win7-rar/Sub-100-Wh-portable-power-station/20261030_233057.jpg

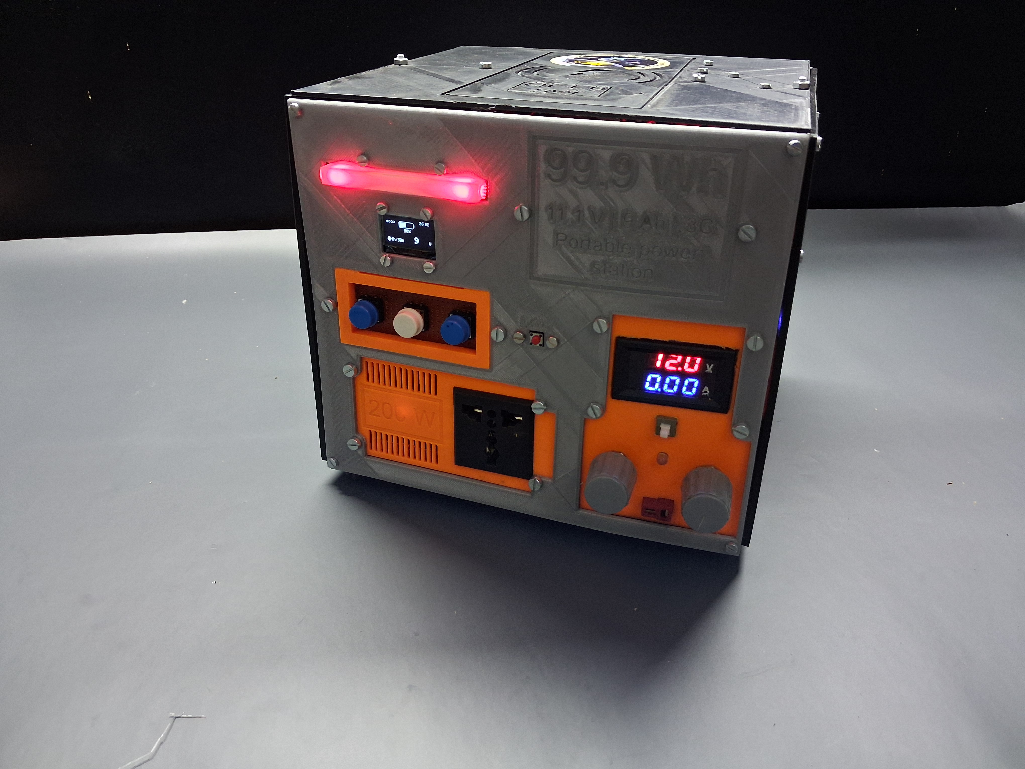
20261030_233057.jpg
