win7-rar/Sub-100-Wh-portable-power-station/20261030_232830.jpg

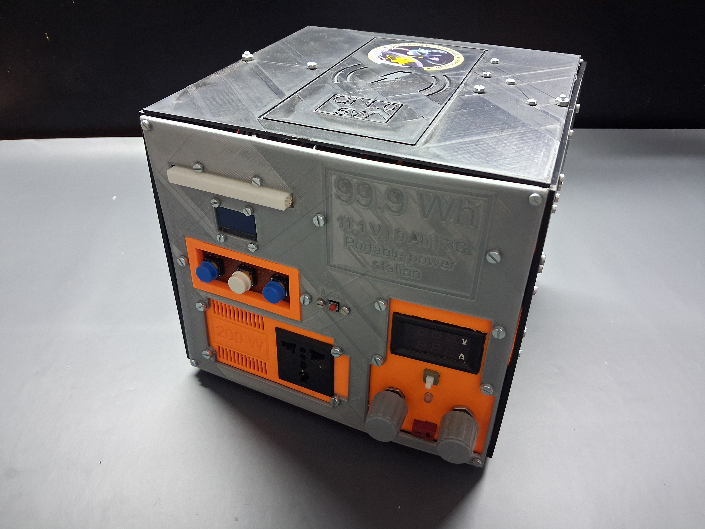
20261030_232830.jpg
