win7-rar/Sub-100-Wh-portable-power-station/PCB/readme.txt

Hi, the circuit I made was one with perf board with random/unplanned placements and connections. This folder
contains circuit diagrams, circuit ideas and solutions to problems. It also contains other miscellaneous information
such as voltage and other characteristics overtime.
