win7-rar/Sub-100-Wh-portable-power-station/20261030_232907.jpg

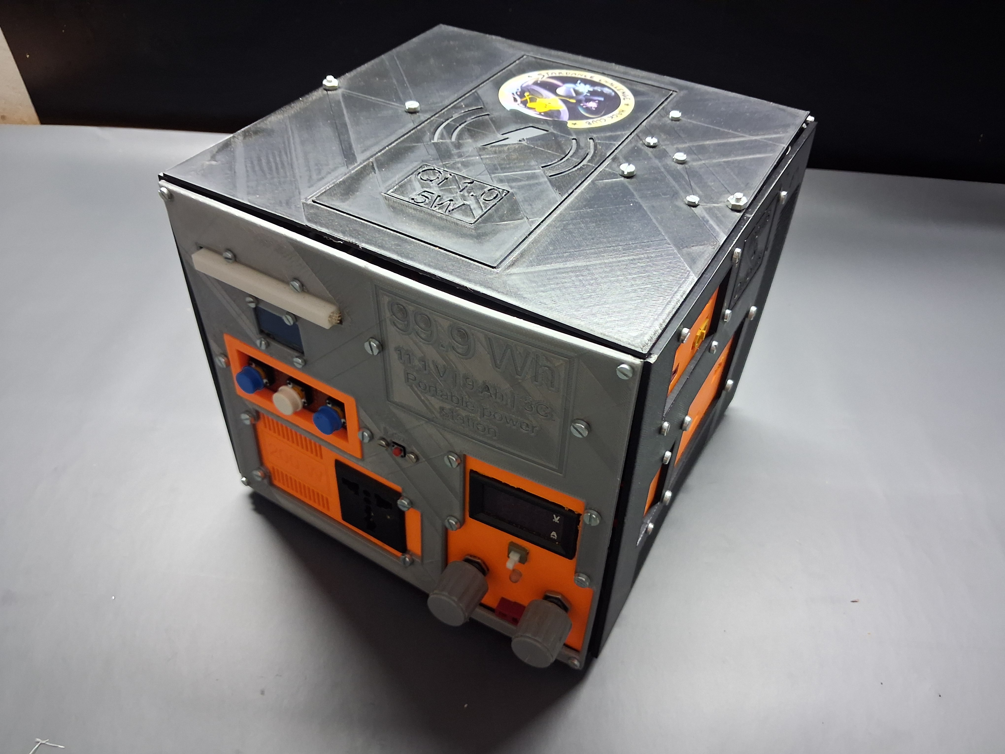
20261030_232907.jpg
