win7-rar/Sub-100-Wh-portable-power-station/PCB/20261030_222210.jpg

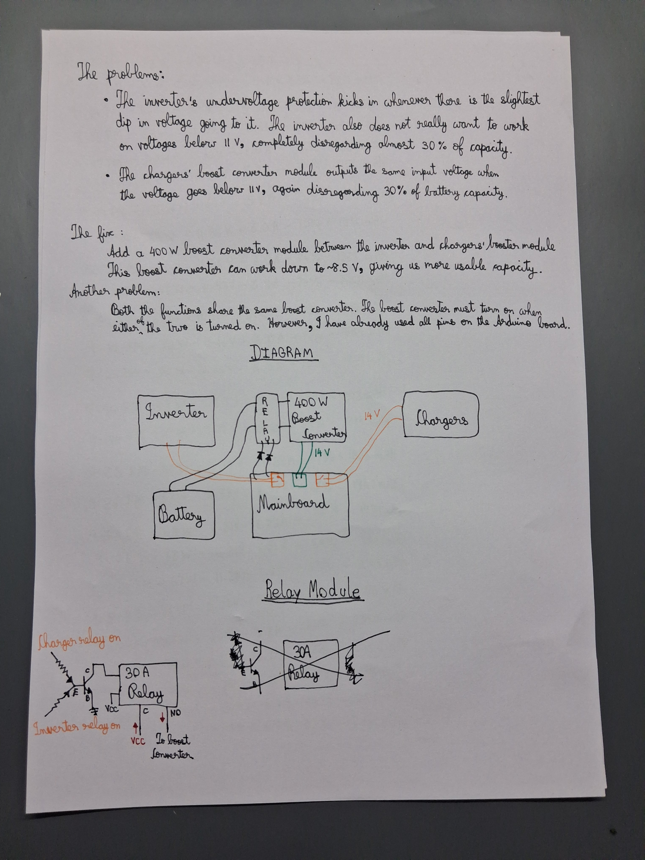
PCB/20261030_222210.jpg
