win7-rar/Sub-100-Wh-portable-power-station/STEP/Mainboard frame bracket.step

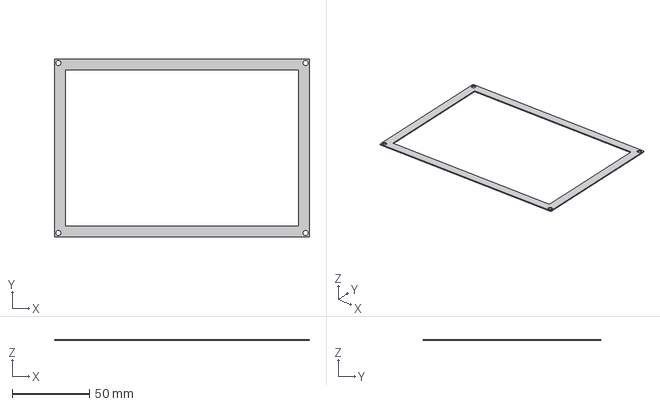
[picture p12: CAD file, 2026-10-30]
STEP/Mainboard frame bracket.step
165.0 x 115.0 x 0.8 mm
