win7-rar/Sub-100-Wh-portable-power-station/STEP/Mainboard mount - right.step

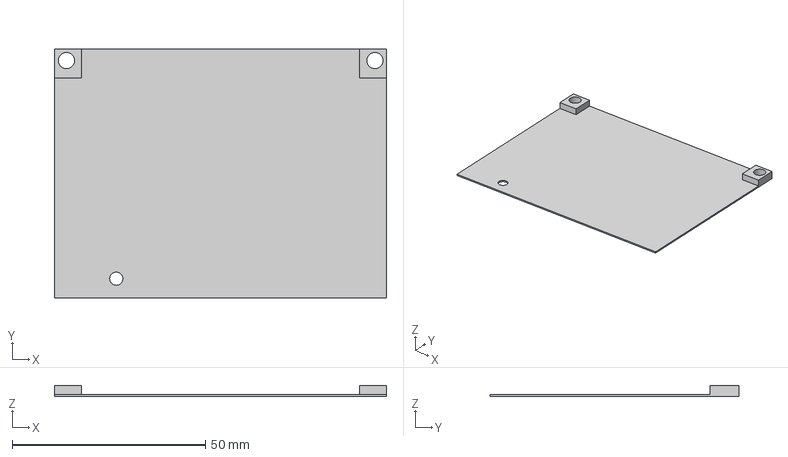
[picture p13: CAD file, 2026-10-30]
STEP/Mainboard mount - right.step
86.0 x 64.5 x 2.80 mm
