win7-rar/Sub-100-Wh-portable-power-station/STEP/Main board mount - left.step

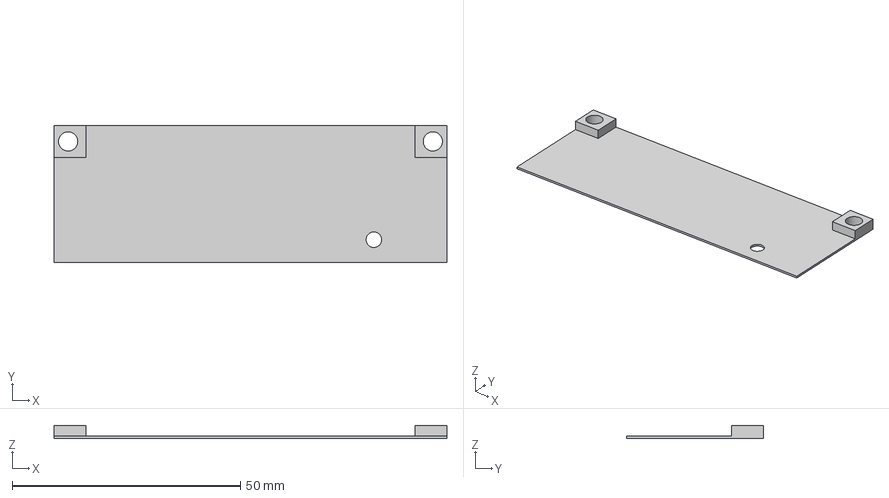
[picture p14: CAD file, 2026-10-30]
STEP/Main board mount - left.step
86.0 x 30.0 x 2.80 mm
