win7-rar/Sub-100-Wh-portable-power-station/STEP/Mainboard frame.step

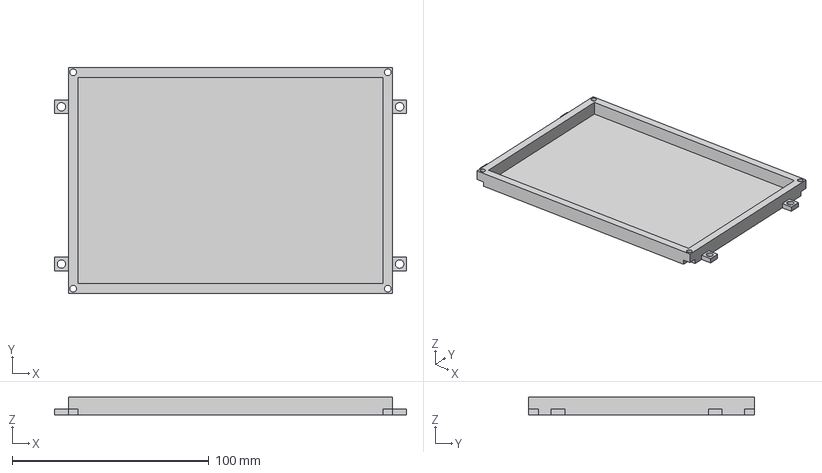
[picture p15: CAD file, 2026-10-30]
STEP/Mainboard frame.step
179.0 x 115.0 x 9.00 mm
