win7-rar/Sub-100-Wh-portable-power-station/STEP/Back panel.step

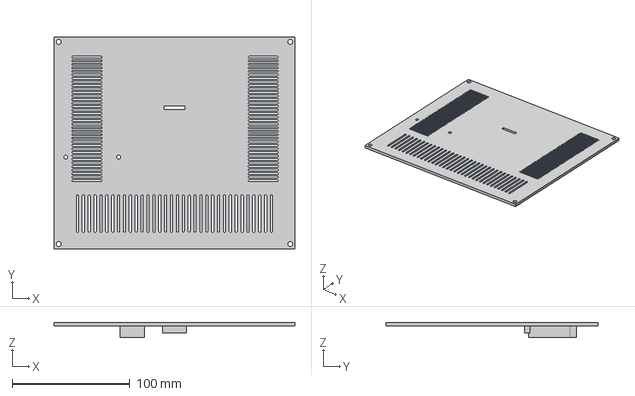
[picture p16: CAD file, 2026-10-30]
STEP/Back panel.step
205.0 x 180.0 x 13.0 mm
