win7-rar/Sub-100-Wh-portable-power-station/STEP/Buttons mount cover.step

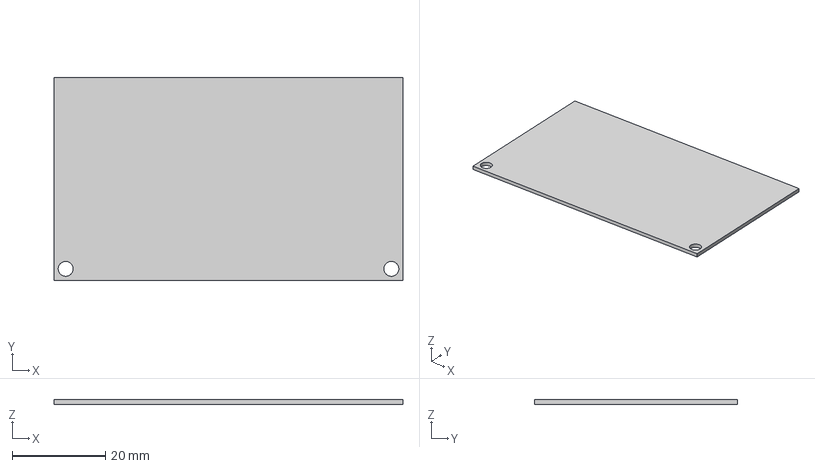
[picture p17: CAD file, 2026-10-30]
STEP/Buttons mount cover.step
75.0 x 43.6 x 1.00 mm
