win7-rar/Sub-100-Wh-portable-power-station/STEP/Bench power supply mount.step

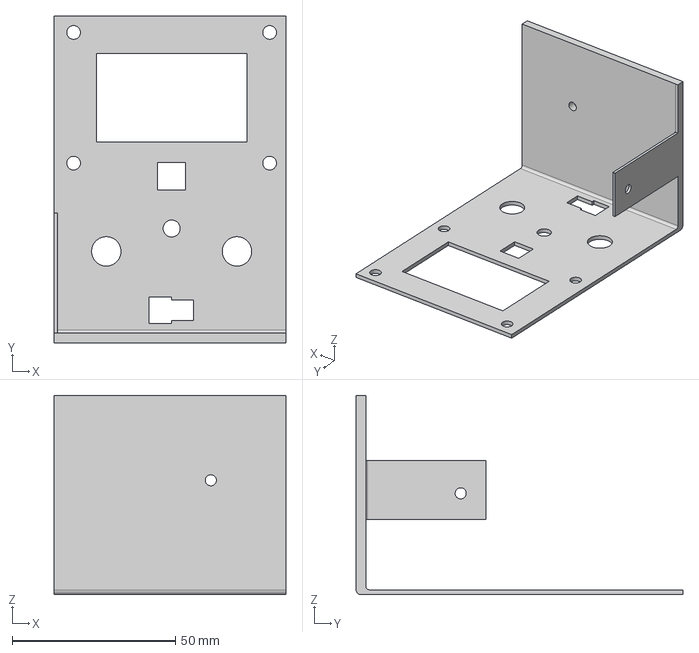
[picture p18: CAD file, 2026-10-30]
STEP/Bench power supply mount.step
71.0 x 100.0 x 61.0 mm
