win7-rar/Sub-100-Wh-portable-power-station/STEP/Inverter case top.step

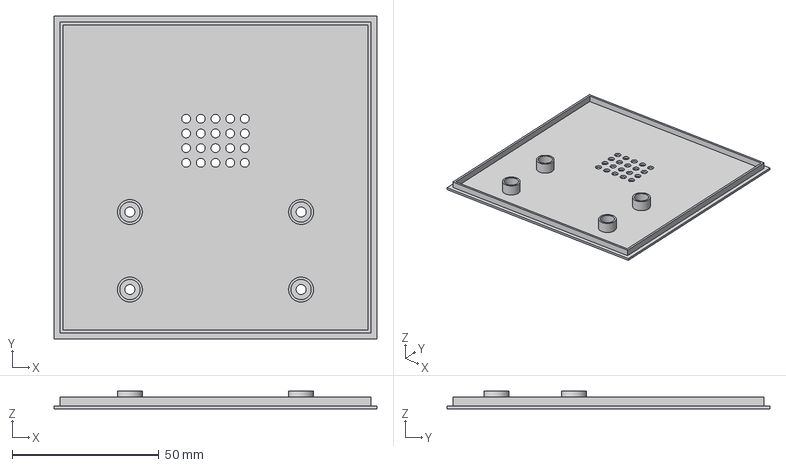
[picture p19: CAD file, 2026-10-30]
STEP/Inverter case top.step
110.0 x 110.0 x 6.00 mm
