win7-rar/Sub-100-Wh-portable-power-station/STEP/Power button mount.step

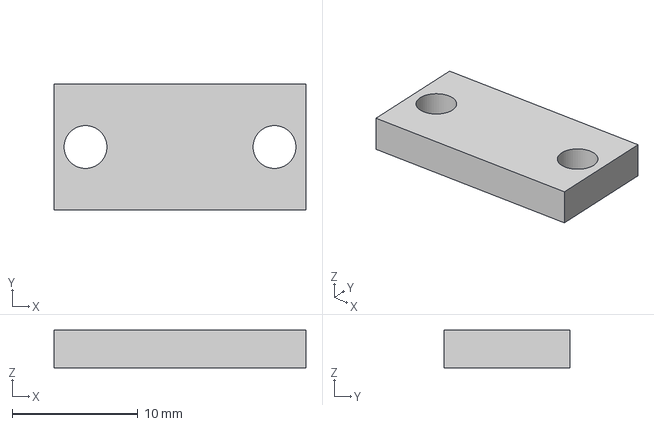
[picture p20: CAD file, 2026-10-30]
STEP/Power button mount.step
20.0 x 10.0 x 3.00 mm
