win7-rar/Sub-100-Wh-portable-power-station/STEP/Battery holder cover.step

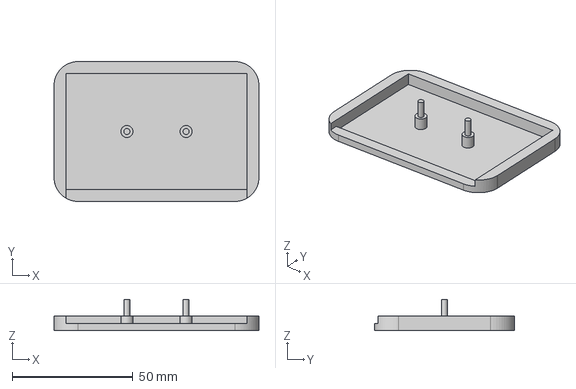
[picture p21: CAD file, 2026-10-30]
STEP/Battery holder cover.step
85.0 x 58.0 x 13.0 mm
