win7-rar/Sub-100-Wh-portable-power-station/STEP/Lamp bracket.step

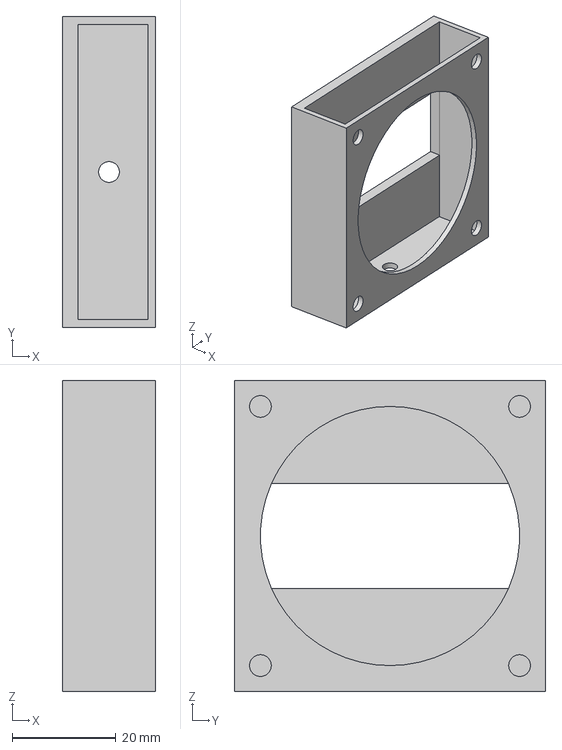
[picture p22: CAD file, 2026-10-30]
STEP/Lamp bracket.step
18.0 x 60.0 x 60.0 mm
