win7-rar/Sub-100-Wh-portable-power-station/STEP/Lamp bracket cover.step

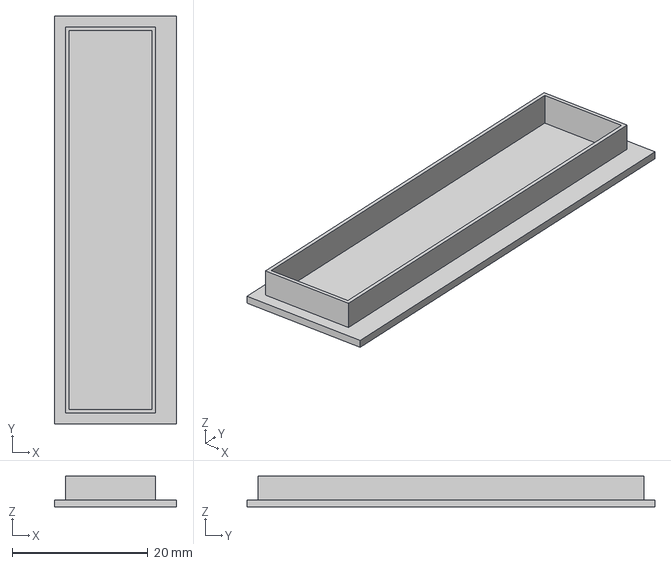
[picture p23: CAD file, 2026-10-30]
STEP/Lamp bracket cover.step
18.0 x 60.0 x 4.50 mm
