win7-rar/Sub-100-Wh-portable-power-station/STEP/Feet.step

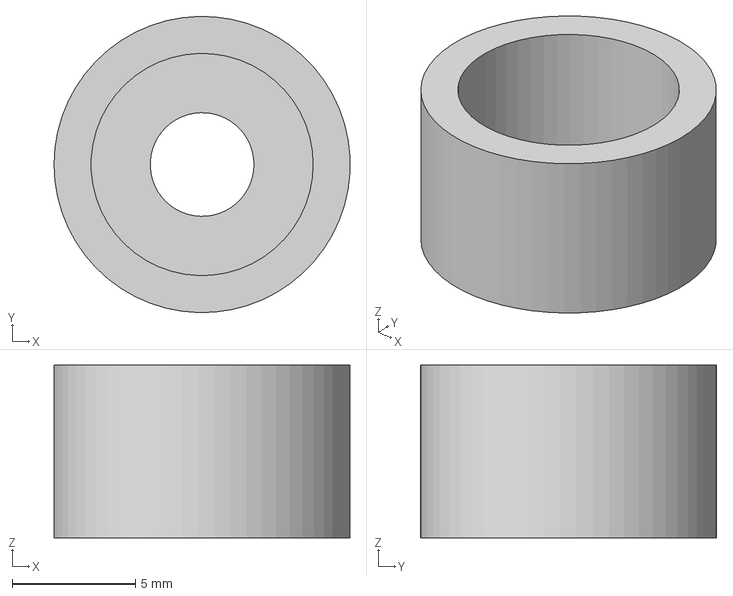
[picture p25: CAD file, 2026-10-30]
STEP/Feet.step
12.0 x 12.0 x 7.00 mm
