win7-rar/Sub-100-Wh-portable-power-station/STEP/Chargers mount.step

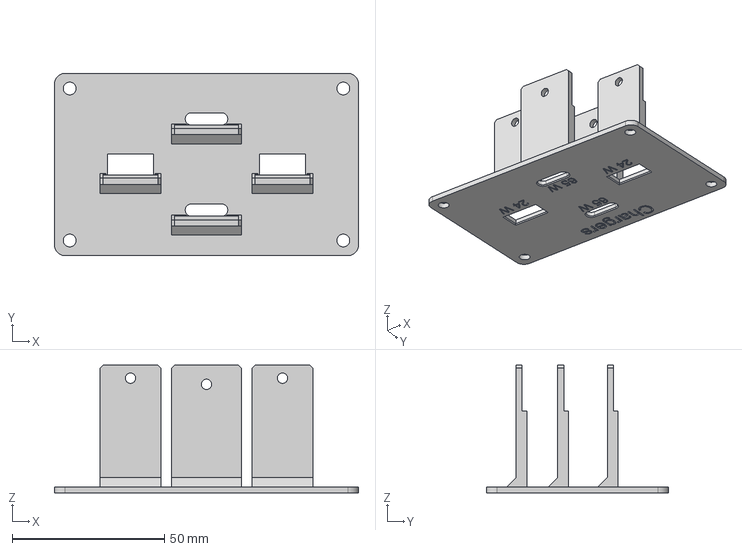
[picture p26: CAD file, 2026-10-30]
STEP/Chargers mount.step
100.0 x 60.0 x 42.0 mm
