win7-rar/Sub-100-Wh-portable-power-station/STEP/Boost converter cover.step

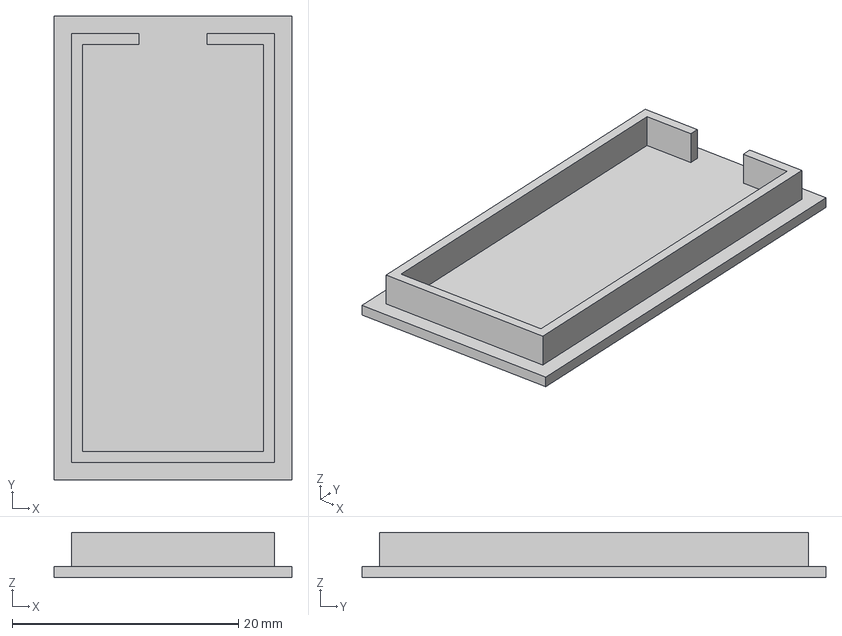
[picture p27: CAD file, 2026-10-30]
STEP/Boost converter cover.step
21.0 x 41.0 x 4.00 mm
