win7-rar/Sub-100-Wh-portable-power-station/STEP/Wireless charger circuit mount.step

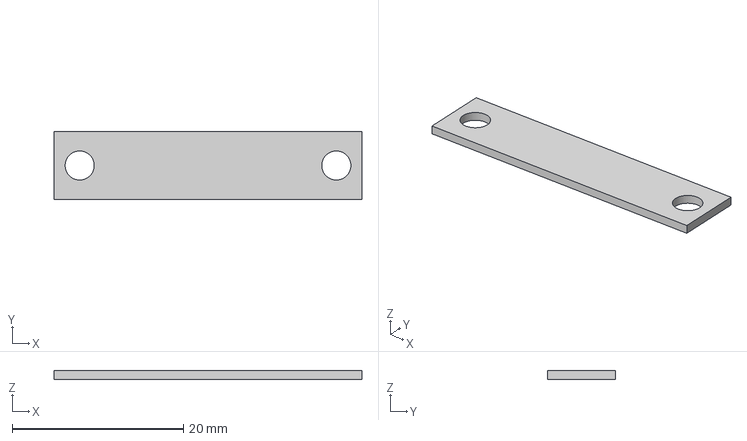
[picture p28: CAD file, 2026-10-30]
STEP/Wireless charger circuit mount.step
36.0 x 8.00 x 1.00 mm
