win7-rar/Sub-100-Wh-portable-power-station/STEP/Wireless charger coil mount.step

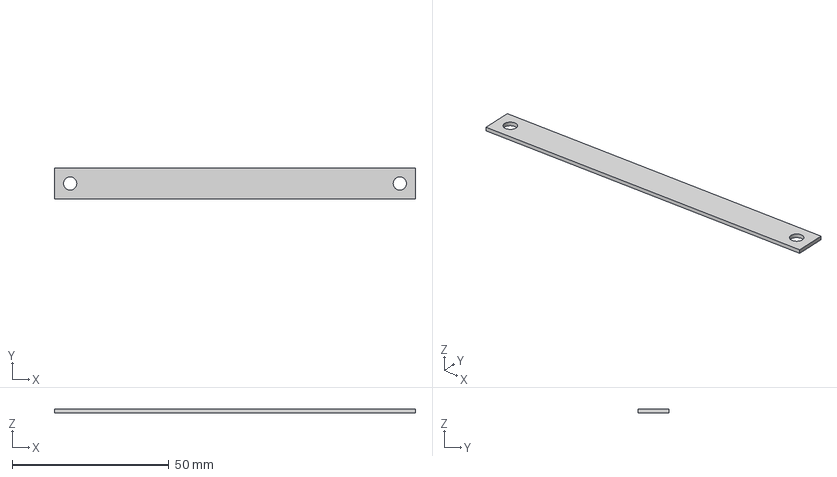
[picture p29: CAD file, 2026-10-30]
STEP/Wireless charger coil mount.step
115.0 x 10.0 x 1.20 mm
