win7-rar/Sub-100-Wh-portable-power-station/STEP/Direct source connector mount.step

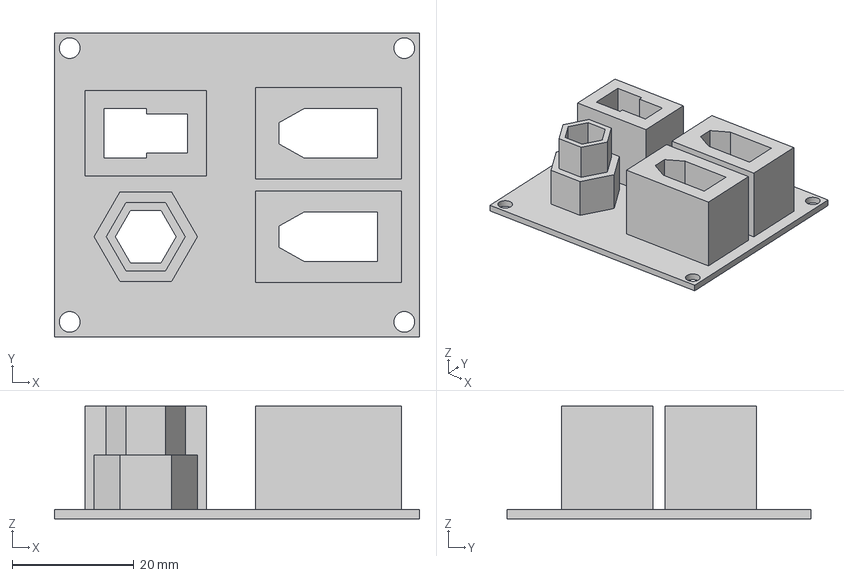
[picture p30: CAD file, 2026-10-30]
STEP/Direct source connector mount.step
60.0 x 50.0 x 18.5 mm
