win7-rar/Sub-100-Wh-portable-power-station/STEP/Buttons mount.step

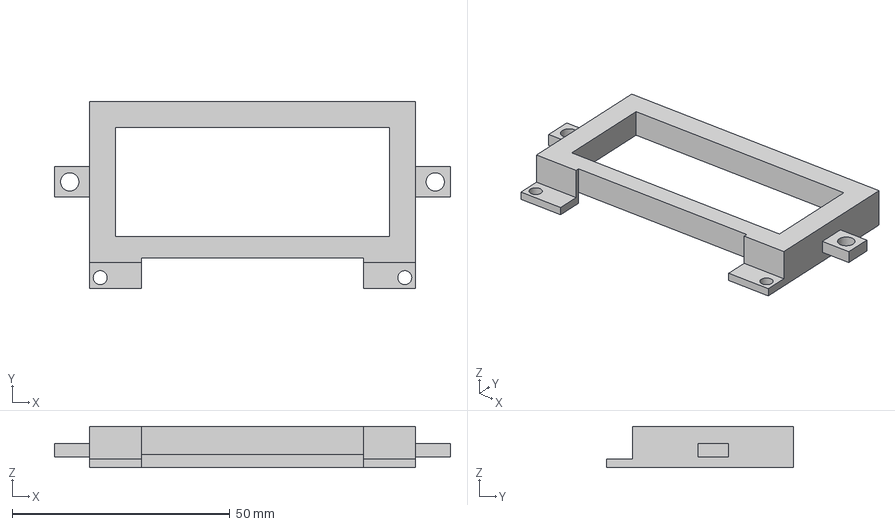
[picture p31: CAD file, 2026-10-30]
STEP/Buttons mount.step
91.0 x 43.0 x 9.50 mm
