win7-rar/Sub-100-Wh-portable-power-station/STEP/Input sources panel.step

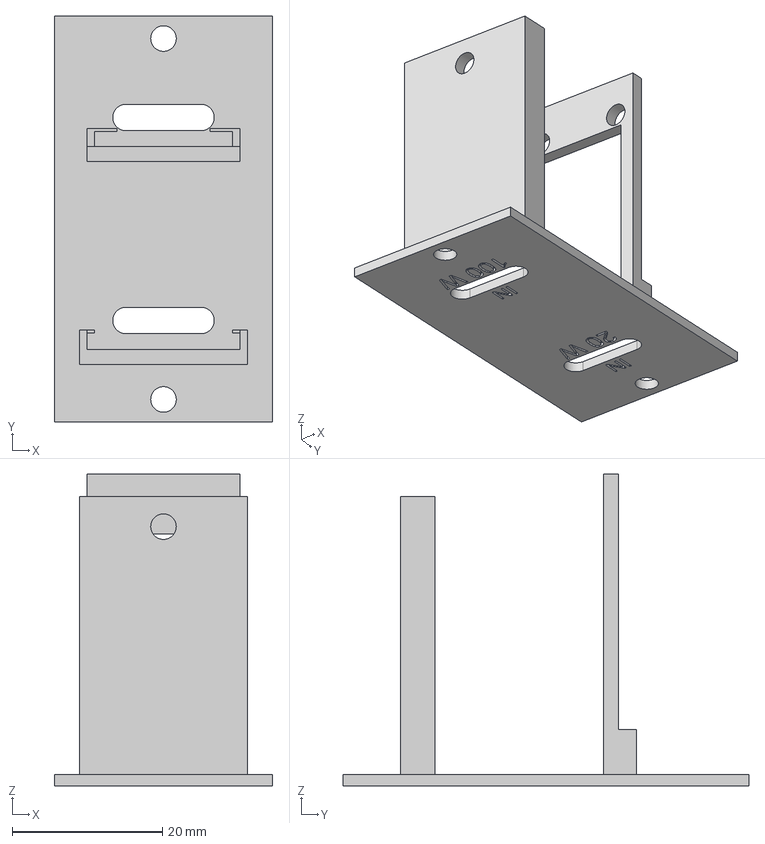
[picture p32: CAD file, 2026-10-30]
STEP/Input sources panel.step
29.0 x 54.0 x 41.5 mm
