win7-rar/Sub-100-Wh-portable-power-station/STEP/Top panel.step

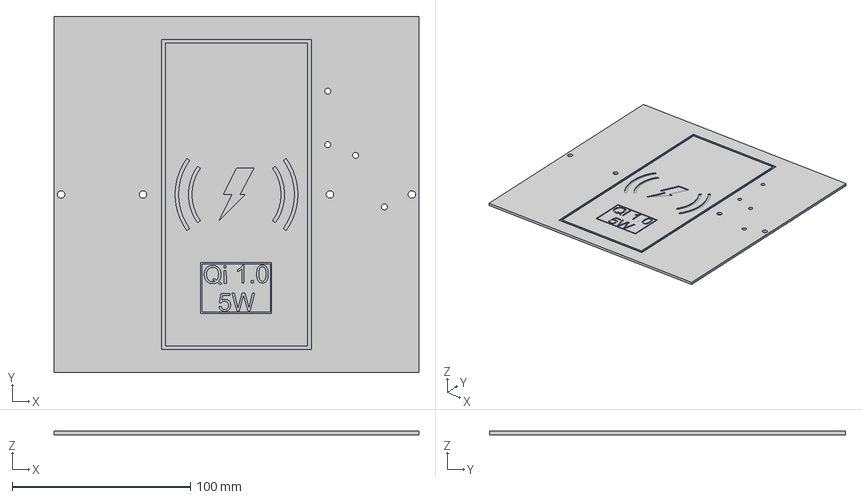
[picture p33: CAD file, 2026-10-30]
STEP/Top panel.step
205.0 x 200.0 x 2.00 mm
