win7-rar/Sub-100-Wh-portable-power-station/STEP/Inverter mount.step

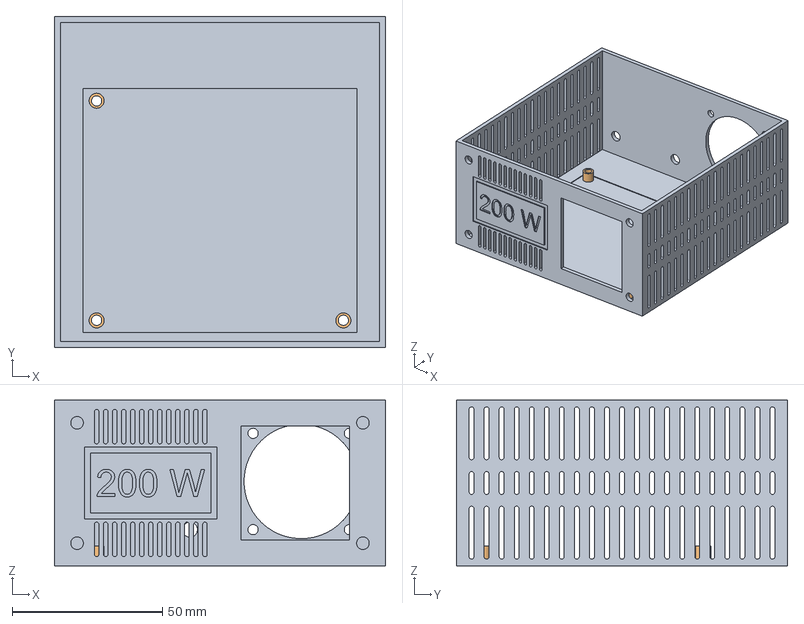
[picture p34: CAD file, 2026-10-30]
STEP/Inverter mount.step
110.0 x 110.0 x 55.0 mm
