win7-rar/Sub-100-Wh-portable-power-station/STEP/Drill guide 32mm.step

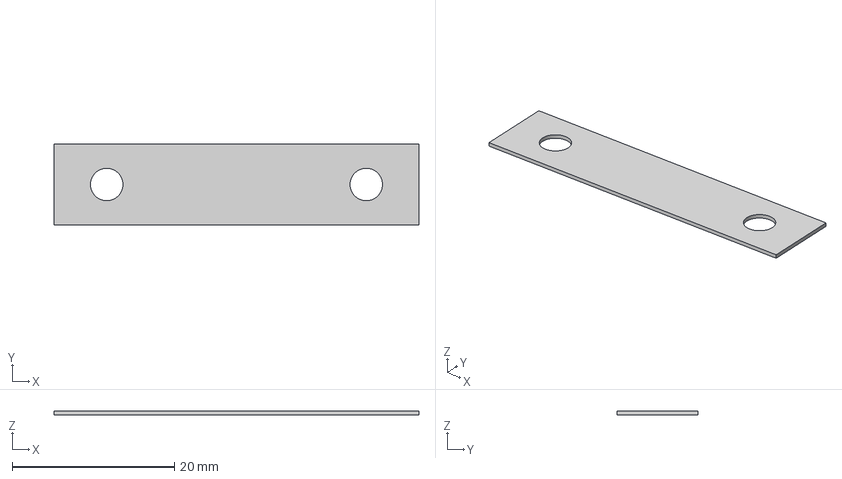
[picture p35: CAD file, 2026-10-30]
STEP/Drill guide 32mm.step
45.0 x 10.0 x 0.5 mm
