win7-rar/Sub-100-Wh-portable-power-station/STEP/Battery mount.step

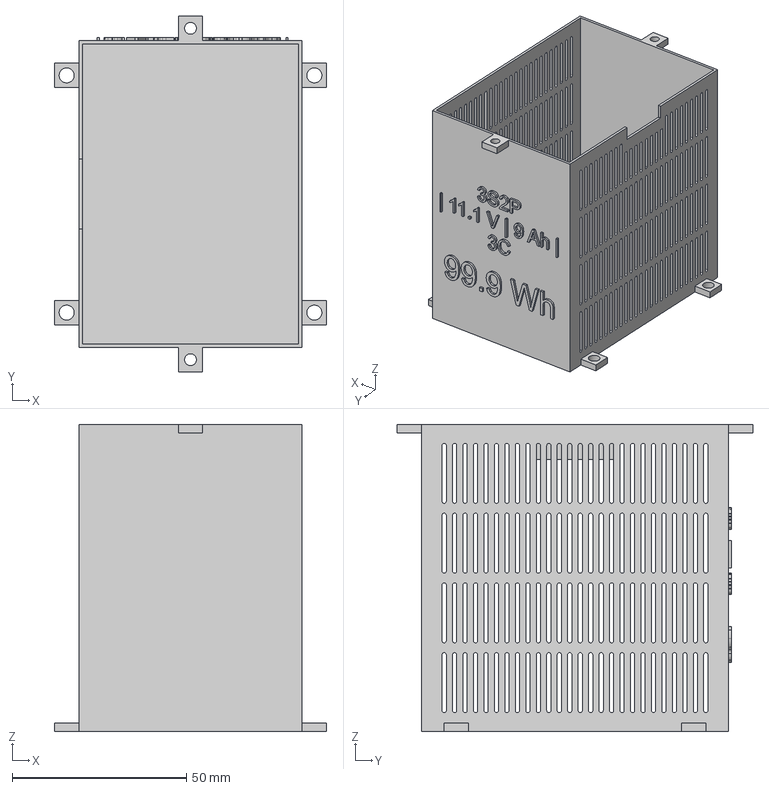
[picture p36: CAD file, 2026-10-30]
STEP/Battery mount.step
78.0 x 102.0 x 88.0 mm
