win7-rar/Sub-100-Wh-portable-power-station/STEP/Battery holder.step

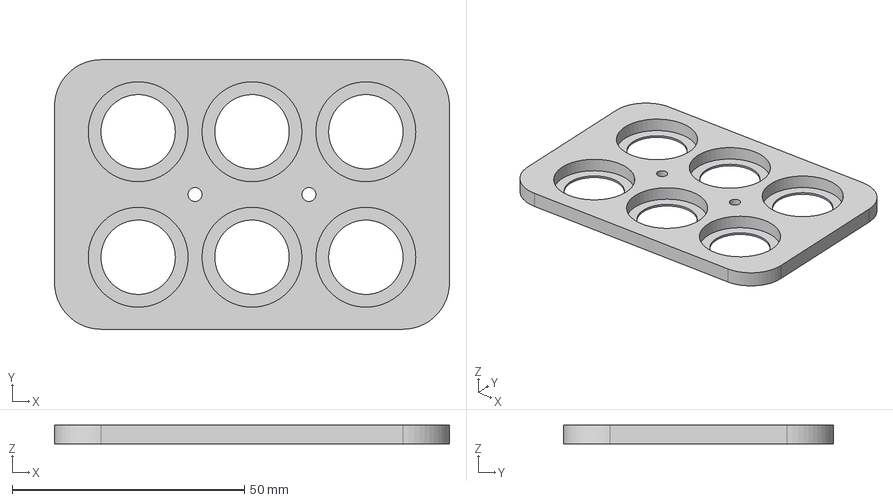
[picture p37: CAD file, 2026-10-30]
STEP/Battery holder.step
85.0 x 58.0 x 4.00 mm
