win7-rar/Sub-100-Wh-portable-power-station/STEP/Bottom panel.step

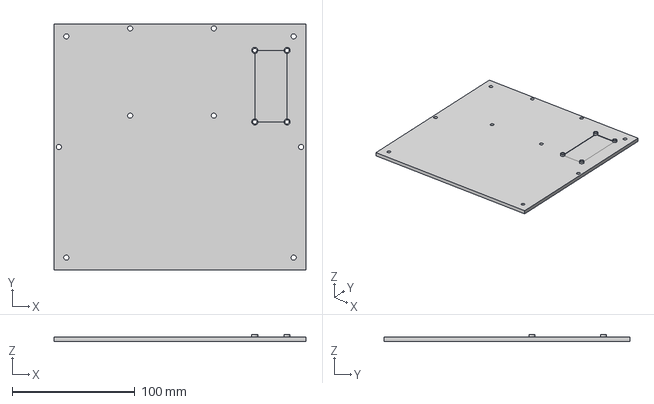
[picture p38: CAD file, 2026-10-30]
STEP/Bottom panel.step
205.0 x 200.0 x 6.00 mm
