win7-rar/Sub-100-Wh-portable-power-station/STEP/Soft starter mount.step

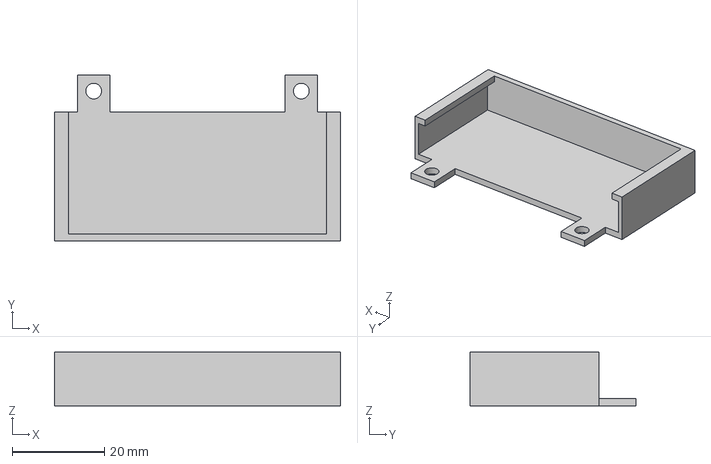
[picture p39: CAD file, 2026-10-30]
STEP/Soft starter mount.step
62.0 x 36.0 x 11.6 mm
