win7-rar/Sub-100-Wh-portable-power-station/STEP/Drill guide 16mm.step

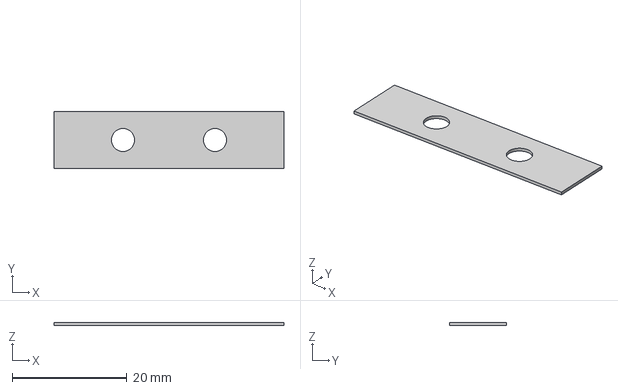
[picture p40: CAD file, 2026-10-30]
STEP/Drill guide 16mm.step
40.0 x 10.0 x 0.5 mm
