win7-rar/Sub-100-Wh-portable-power-station/STEP/Accent light bar.step

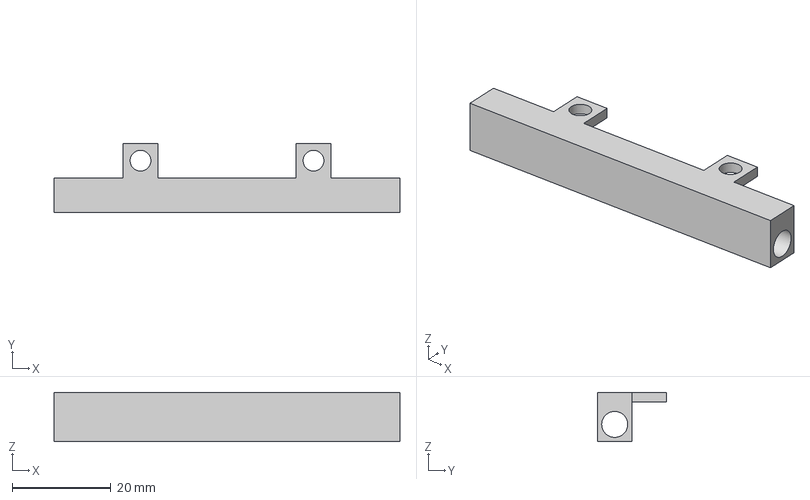
[picture p41: CAD file, 2026-10-30]
STEP/Accent light bar.step
70.0 x 14.0 x 10.0 mm
