win7-rar/Sub-100-Wh-portable-power-station/STEP/LED diffuser.step

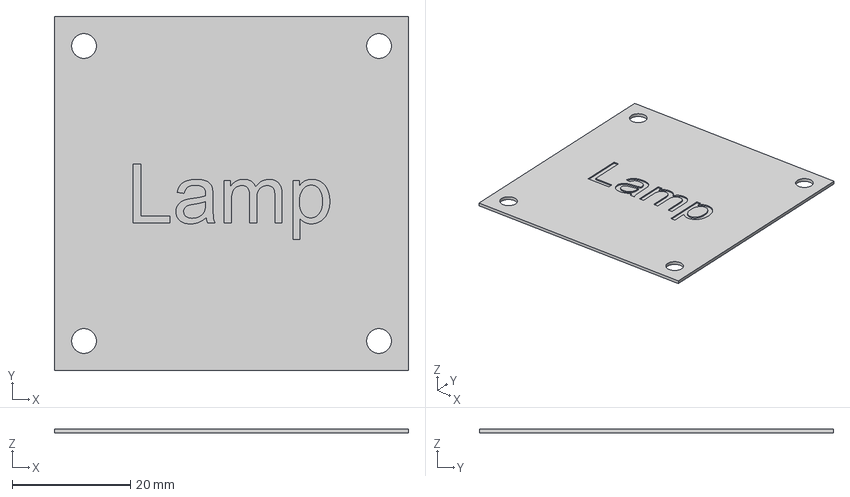
[picture p42: CAD file, 2026-10-30]
STEP/LED diffuser.step
60.0 x 60.0 x 0.76 mm
