win7-rar/Sub-100-Wh-portable-power-station/STEP/Haptic block - Case.step

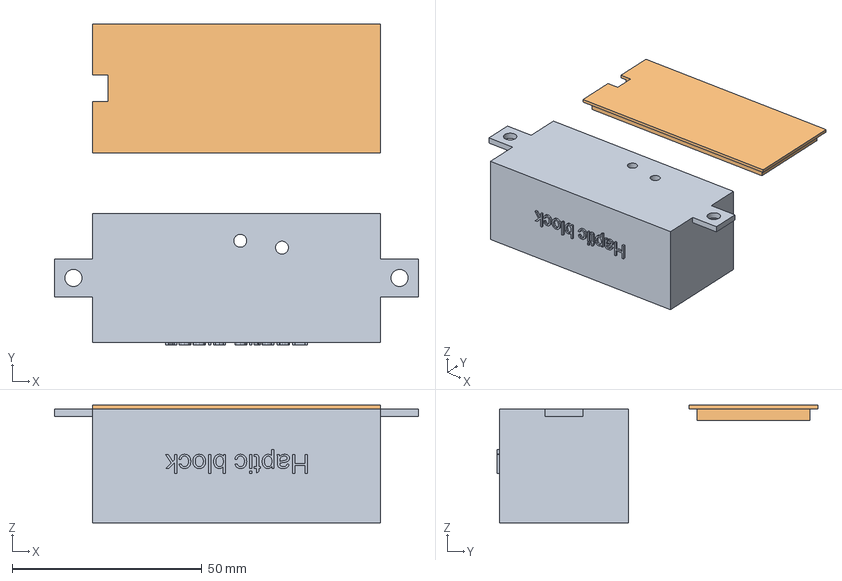
[picture p43: CAD file, 2026-10-30]
STEP/Haptic block - Case.step
96.0 x 84.7 x 31.0 mm
