win7-rar/Sub-100-Wh-portable-power-station/STEP/Side panel - right.step

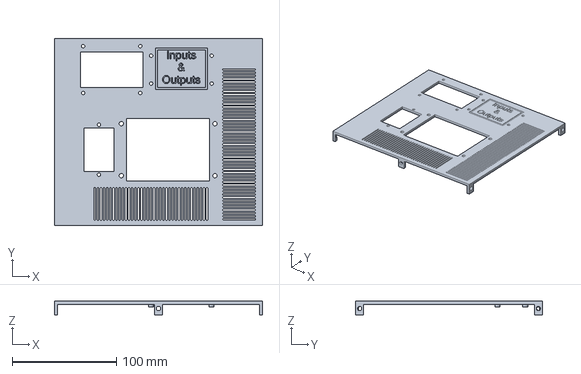
[picture p44: CAD file, 2026-10-30]
STEP/Side panel - right.step
200.0 x 180.0 x 13.0 mm
