win7-rar/Sub-100-Wh-portable-power-station/STEP/Battery mount top cover.step

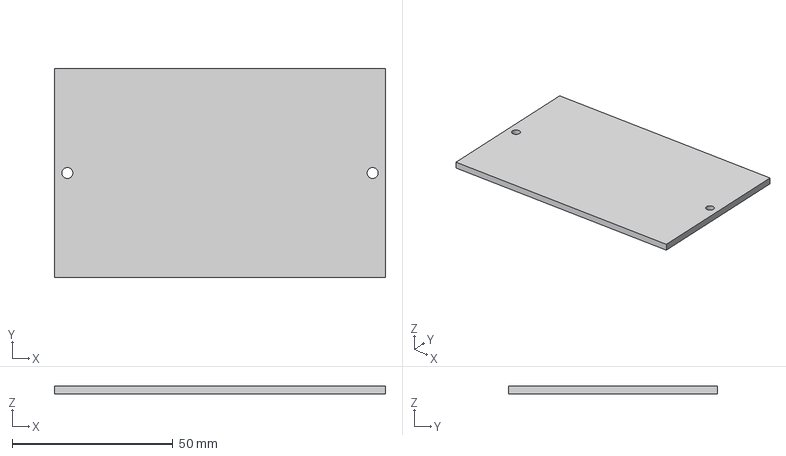
[picture p45: CAD file, 2026-10-30]
STEP/Battery mount top cover.step
103.0 x 65.0 x 2.60 mm
