win7-rar/Sub-100-Wh-portable-power-station/STEP/Front panel.step

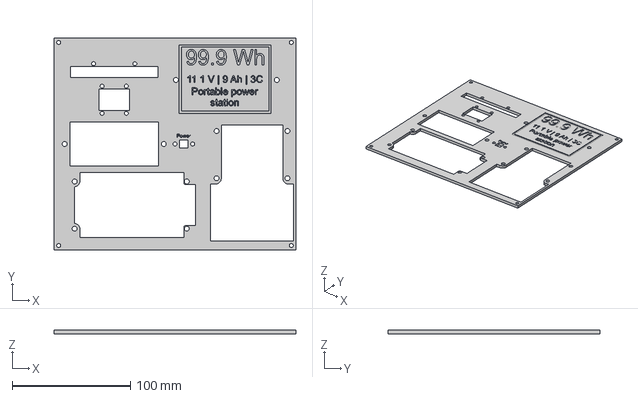
[picture p46: CAD file, 2026-10-30]
STEP/Front panel.step
205.0 x 180.0 x 3.00 mm
