win7-rar/Sub-100-Wh-portable-power-station/(list of files, cad)

Other CAD files:
STEP/Entire 3D printed part assembly.step
F3D/Accent light bar.f3d
F3D/Back panel.f3d
F3D/Battery holder cover.f3d
F3D/Battery holder.f3d
F3D/Battery mount top cover.f3d
F3D/Battery mount.f3d
F3D/Bench power supply mount.f3d
F3D/Boost converter cover.f3d
F3D/Bottom panel.f3d
F3D/Buttons mount cover.f3d
F3D/Buttons mount.f3d
F3D/Chargers mount.f3d
F3D/Direct source connector mount.f3d
F3D/Drill guide 16mm.f3d
F3D/Drill guide 32mm.f3d
F3D/Entire 3D printed part assembly.f3d
F3D/Feet.f3d
F3D/Front panel.f3d
F3D/Haptic block - Case.f3d
F3D/Input sources panel.f3d
F3D/Inverter case top.f3d
F3D/Inverter mount.f3d
F3D/Inverter top panel screw cover.f3d
F3D/LED diffuser.f3d
F3D/Lamp bracket cover.f3d
F3D/Lamp bracket.f3d
F3D/Main board mount - left.f3d
F3D/Mainboard frame bracket.f3d
F3D/Mainboard frame.f3d
F3D/Mainboard mount - right.f3d
F3D/Power button mount.f3d
F3D/Side panel - left.f3d
F3D/Side panel - right.f3d
F3D/Soft starter mount.f3d
F3D/Top panel.f3d
F3D/Wireless charger circuit mount.f3d
F3D/Wireless charger coil mount.f3d
STEP/Inverter top panel screw cover.step
STL/Accent light bar.stl
STL/Back panel.stl
STL/Battery holder cover.stl
STL/Battery holder.stl
STL/Battery mount top cover.stl
STL/Battery mount.stl
STL/Bench power supply mount.stl
STL/Boost converter cover.stl
STL/Bottom panel.stl
STL/Buttons mount cover.stl
STL/Buttons mount.stl
STL/Chargers mount.stl
STL/Direct source connector mount.stl
STL/Drill guide 16mm.stl
STL/Drill guide 32mm.stl
STL/Feet.stl
STL/Front panel.stl
STL/Haptic block - Case.stl
STL/Input sources panel.stl
STL/Inverter case top.stl
STL/Inverter mount.stl
STL/Inverter top panel screw cover.stl
STL/LED diffuser.stl
STL/Lamp bracket cover.stl
STL/Lamp bracket.stl
STL/Main board mount - left.stl
STL/Mainboard frame bracket.stl
STL/Mainboard frame.stl
STL/Mainboard mount - right.stl
STL/Power button mount.stl
STL/Side panel - left.stl
STL/Side panel - right.stl
STL/Soft starter mount.stl
STL/Top panel.stl
STL/Wireless charger circuit mount.stl
STL/Wireless charger coil mount.stl
