win7-rar/Sub-100-Wh-portable-power-station/(commit log)

2026-10-30 Enhance README with detailed project information
    Expanded the README to include detailed features, CAD parts, circuit description, firmware development insights, and BOM information for the portable power station.
2026-10-30 Add image to README for portable power station
    Added an image to the README for better visual representation.
